ayuusweetfish/Humming-Cumulus/README.md

# Humming Cumulus

[**概念展示动画 / Concept demo animation**](https://ayu.land/flow/rush/Cu_hum.mp4)

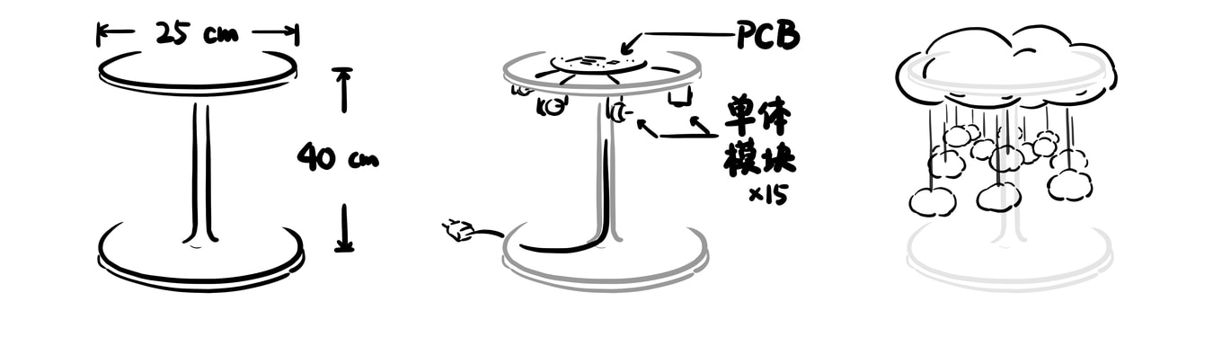
[picture p1: images/CuHum_Appearance.jpg]
外观设计草图。


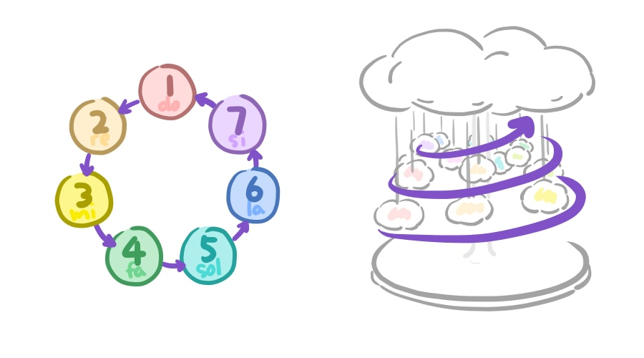
[picture p2: images/CuHum_Solfege.jpg]
按照音名排列的云朵。


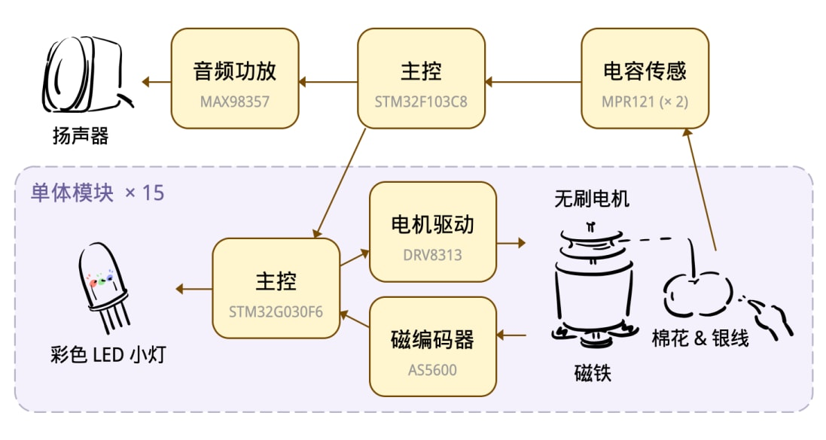
[picture p3: images/CuHum_Block.jpg]
技术原理框图，包括总体的主控和 15 个单体模块。
