ayuusweetfish/Humming-Cumulus/Cloud_Unit/mech/CloudUnit_Chassis.FCStd

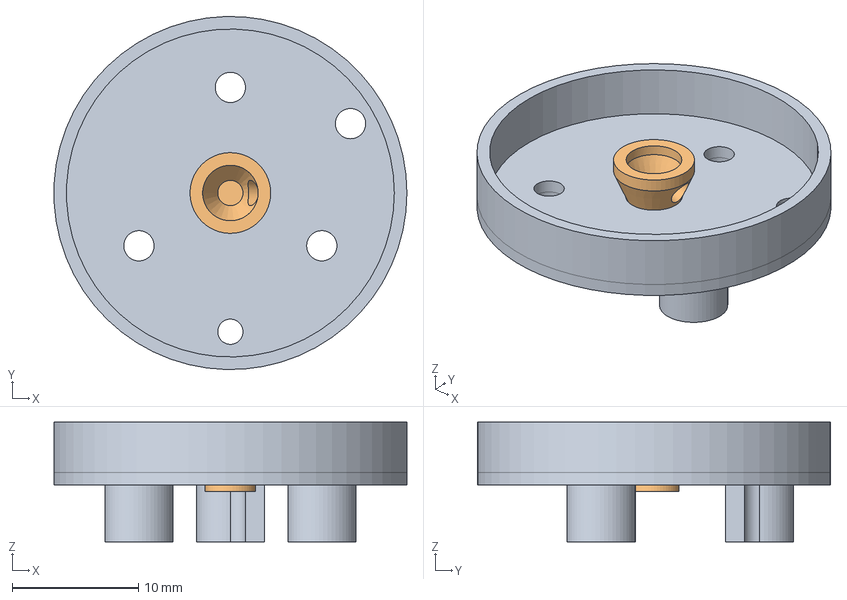
[picture p10: CAD file, 2024-01-27]
Cloud_Unit/mech/CloudUnit_Chassis.FCStd
28.0 x 28.0 x 9.50 mm
