ayuusweetfish/Humming-Cumulus/Cloud_Unit/mech/CloudUnit_Spindle.FCStd

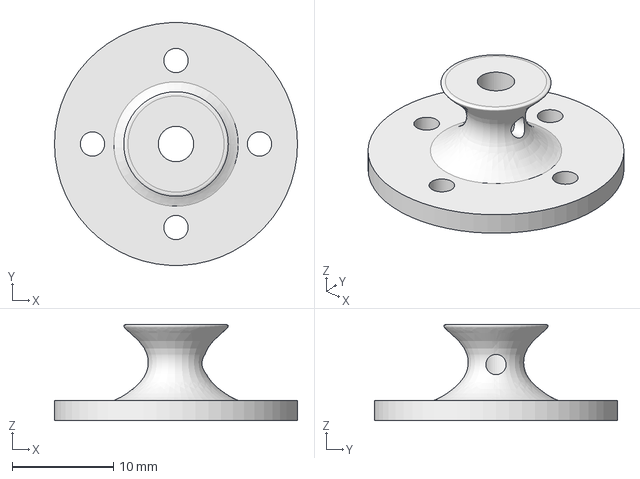
[picture p11: CAD file, 2024-01-27]
Cloud_Unit/mech/CloudUnit_Spindle.FCStd
24.0 x 24.0 x 9.50 mm
