ayuusweetfish/Humming-Cumulus/Cloud_Unit/mech/CloudUnit_ElevRing.FCStd

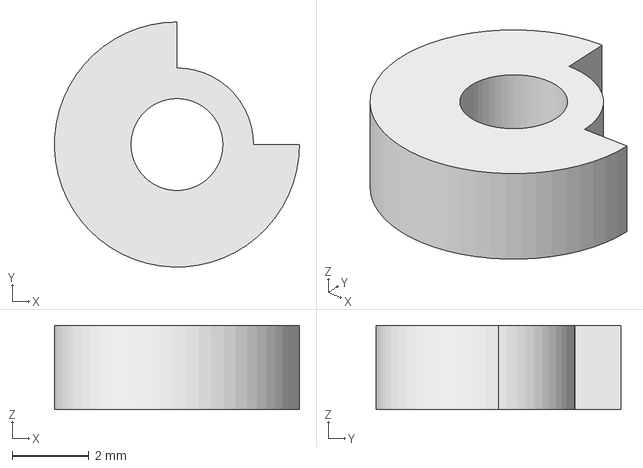
[picture p12: CAD file, 2024-01-07]
Cloud_Unit/mech/CloudUnit_ElevRing.FCStd
6.40 x 6.40 x 2.20 mm
