ayuusweetfish/Humming-Cumulus/misc/paper/Block.pdf

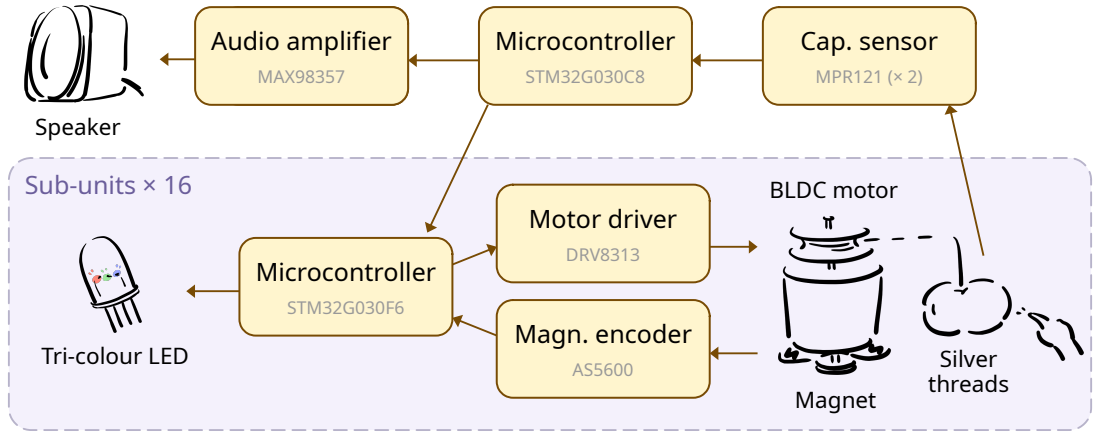
[picture p13: page 1]
Audio Amp; MAX98357; BLDC motor; Magnet; Sub-units × 16; Silver threads; Speaker; Audio amplifier; Microcontroller; STM32G030C8; Cap. sensor; MPR121 (× 2); STM32G030F6; Motor driver; DRV8313; Magn. encoder

Tri-colour LED
