ayuusweetfish/Humming-Cumulus/Main_Board/hw/CuHum_Main.kicad_pcb

## KiCad design Main_Board/hw/CuHum_Main.kicad_pcb (2024-01-27)

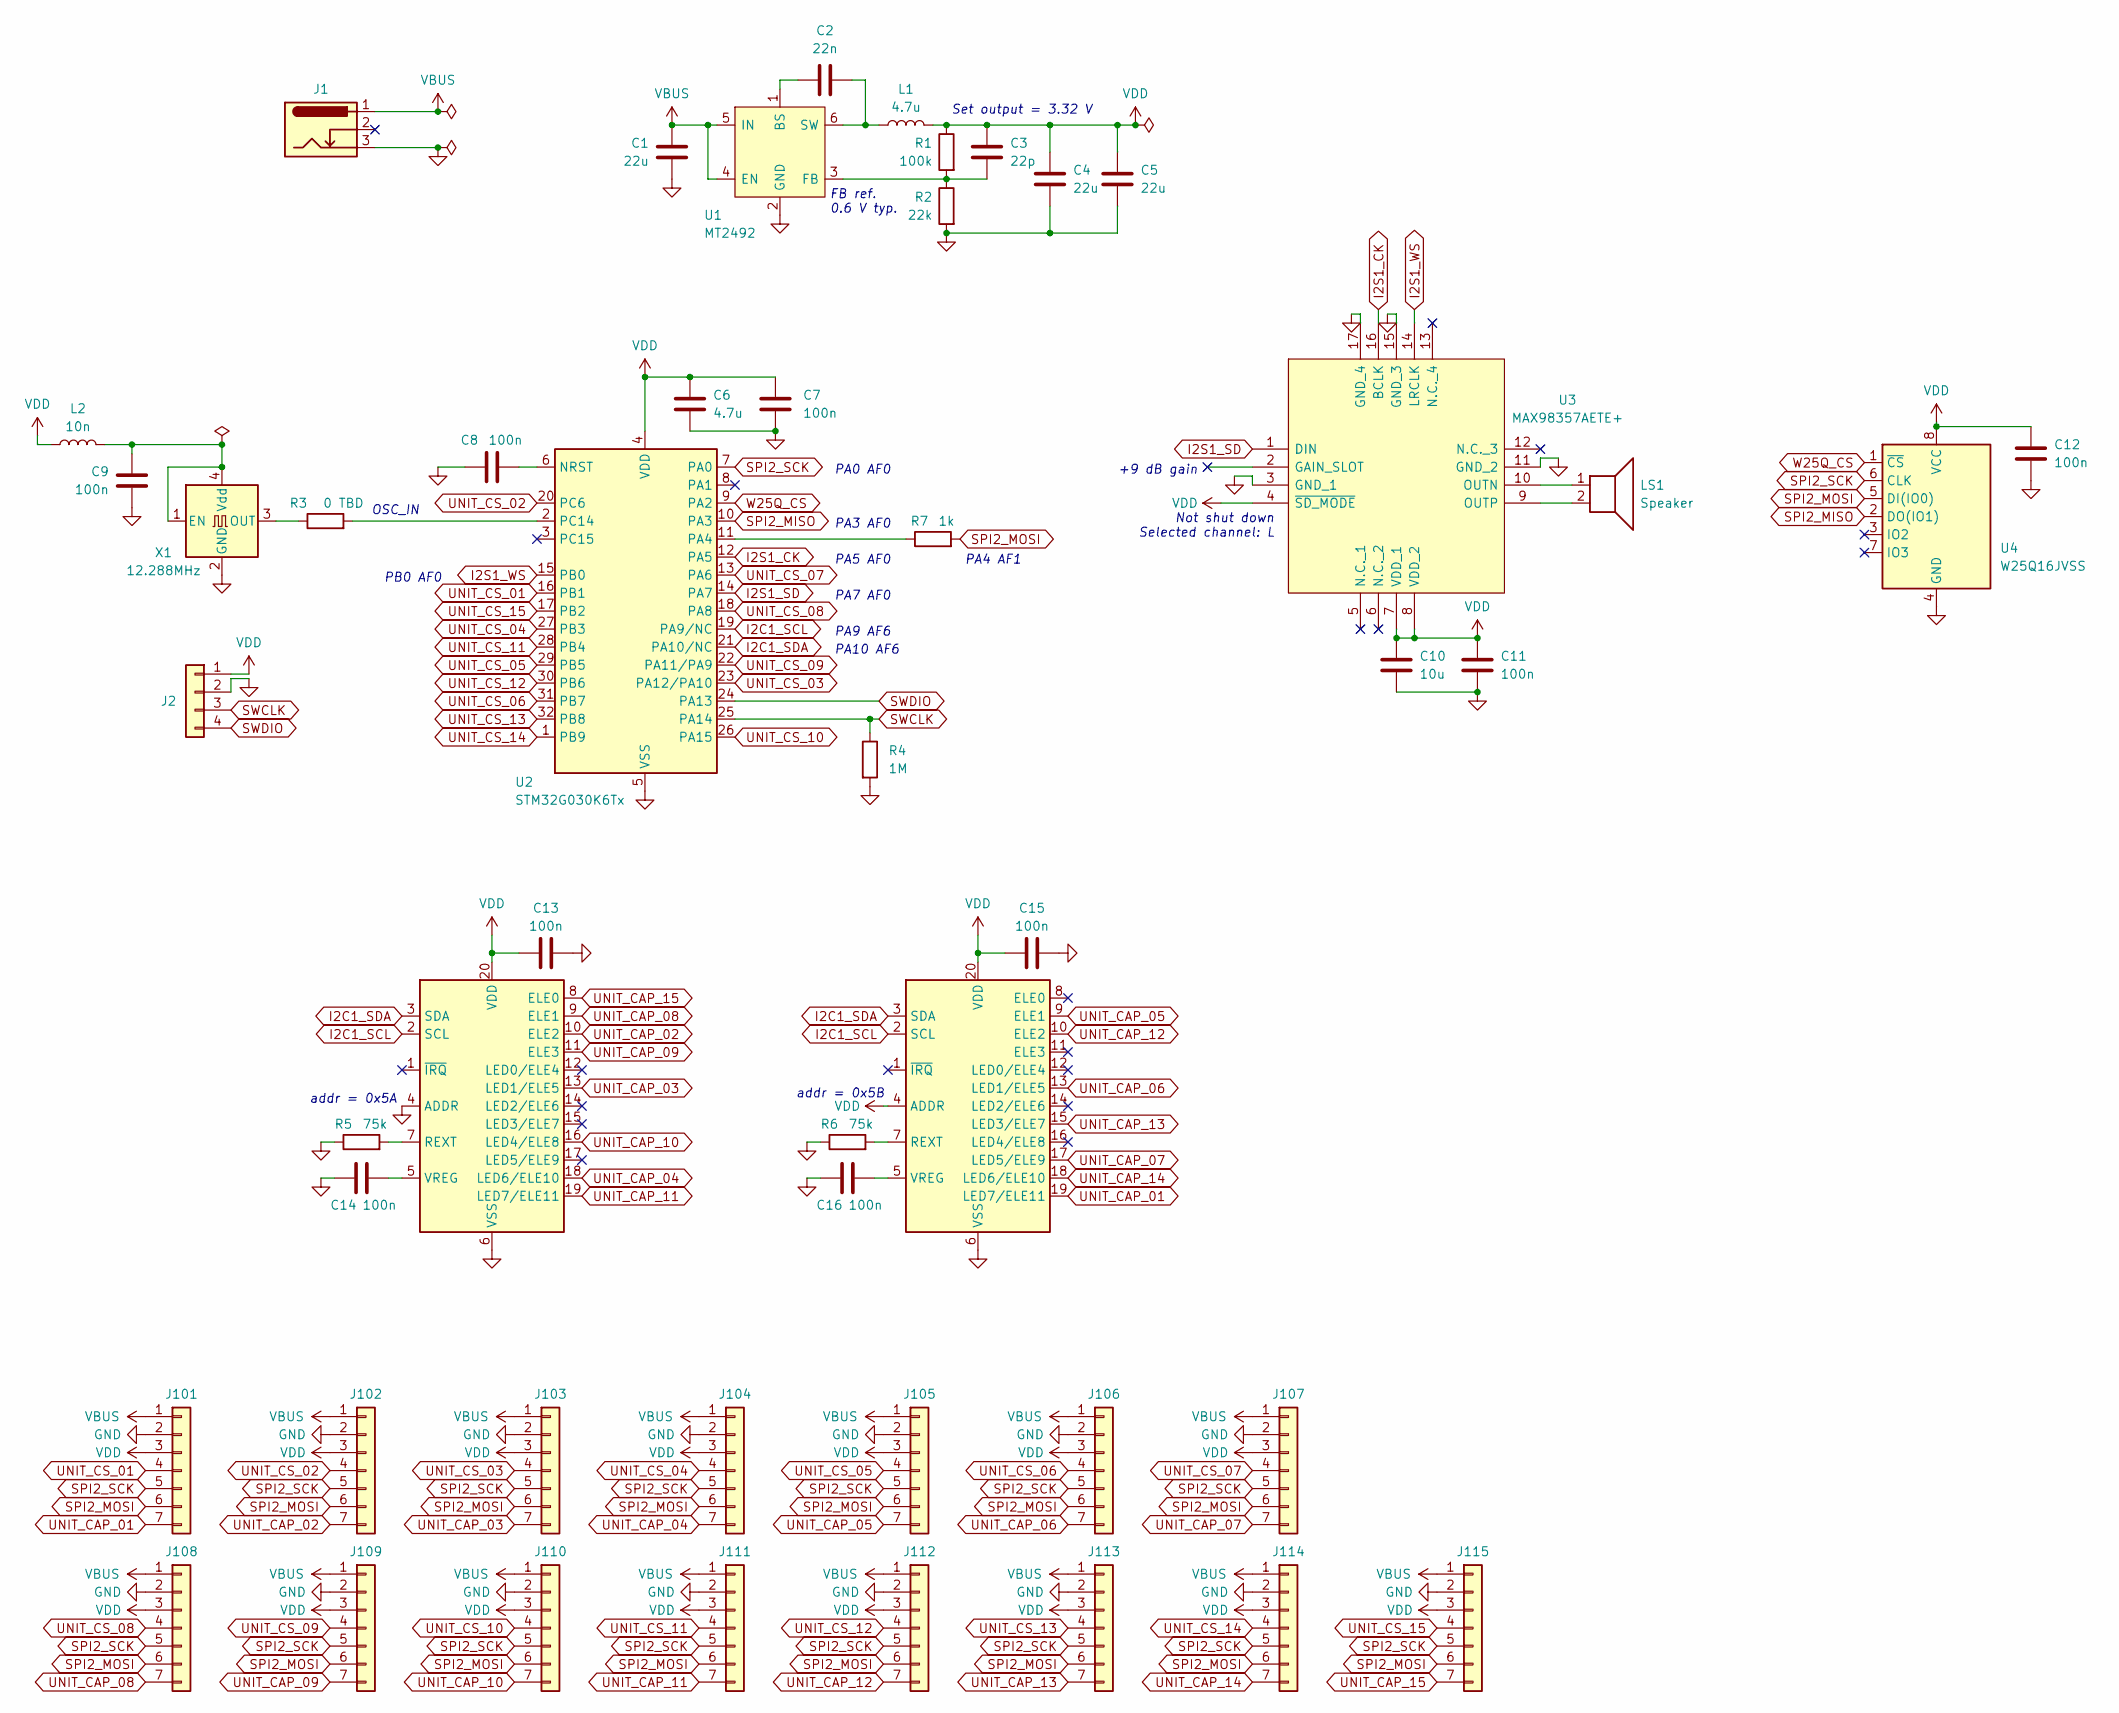
[picture p14: schematic CuHum_Main.kicad_sch]

Parts:
C1, C4, C5: 22u; C_0603_1608Metric
C2: 22n; C_0603_1608Metric
C3: 22p; C_0603_1608Metric
C6: 4.7u; C_0603_1608Metric
C7, C8, C11, C12, C13, C14, C15, C16: 100n; C_0603_1608Metric
C9: 100n; C_0402_1005Metric
C10: 10u; C_0603_1608Metric
J1: Barrel_Jack_Switch_Pin3Ring; BarrelJack_DC022
J2: Conn_01x04; TestPoints_1x04_P2.54
J101, J102, J103, J104, J105, J106, J107, J108, J109, J110, J111, J112, J113, J114, J115: Conn_01x07; Unit_1x07_P2.54
L1: 4.7u; L_Sunlord_MWSA1004S
L2: 10n; L_0402_1005Metric
LS1: Speaker; PinHeader_1x02_P2.54mm_Vertical
R1: 100k; R_0603_1608Metric
R2: 22k; R_0603_1608Metric
R3: 0 TBD; R_0603_1608Metric
R4: 1M; R_0603_1608Metric
R5, R6: 75k; R_0603_1608Metric
R7: 1k; R_0603_1608Metric
U1: MT2492; SOT-23-6; Manufacturer_Part_Number MT2492
U2: STM32G030K6Tx; LQFP-32_7x7mm_P0.8mm
U3: MAX98357AETE+; QFN-16-1EP_3x3mm_P0.5mm_EP1.45x1.45mm; Manufacturer_Part_Number MAX98357AETE+; Mouser Part Number 700-MAX98357AETE+
U4: W25Q16JVSS; SOIC-8_5.23x5.23mm_P1.27mm
U5, U6: MPR121QR2; UQFN-20_3x3mm_P0.4mm
X1: 12.288MHz; Oscillator_SMD_Abracon_ASE-4Pin_3.2x2.5mm

Connections:
GND: C1.2, C4.2, C5.2, C6.2, C7.2, C8.1, C9.2, C10.2, C11.2, C12.2, C13.2, C14.1, C15.2, C16.1, J1.3, J2.2, J101.2, J102.2, J103.2, J104.2, J105.2, J106.2, J107.2, J108.2, J109.2, J110.2, J111.2, J112.2, J113.2, J114.2, J115.2, R2.2, R4.2, R5.1, R6.1, U1.2 (GND), U2.5 (VSS), U3.3 (GND_1), U3.11 (GND_2), U3.15 (GND_3), U3.17 (GND_4), U4.4 (GND), U5.4 (ADDR), U5.6 (VSS), U6.6 (VSS), X1.2 (GND)
I2C1_SCL: U2.19 (PA9/NC), U5.2 (SCL), U6.2 (SCL)
I2C1_SDA: U2.21 (PA10/NC), U5.3 (SDA), U6.3 (SDA)
I2S1_CK: U2.12 (PA5), U3.16 (BCLK)
I2S1_SD: U2.14 (PA7), U3.1 (DIN)
I2S1_WS: U2.15 (PB0), U3.14 (LRCLK)
unnamed: C2.1, U1.1 (BS)
unnamed: C3.2, R1.2, R2.1, U1.3 (FB)
unnamed: C2.2, L1.1, U1.6 (SW)
unnamed: C8.2, U2.6 (NRST)
unnamed: R7.1, U2.11 (PA4)
unnamed: R3.2, U2.2 (PC14)
unnamed: LS1.1, U3.10 (OUTN)
unnamed: LS1.2, U3.9 (OUTP)
unnamed: R5.2, U5.7 (REXT)
unnamed: C14.2, U5.5 (VREG)
unnamed: R6.2, U6.7 (REXT)
unnamed: C16.2, U6.5 (VREG)
unnamed: C9.1, L2.2, X1.1 (EN), X1.4 (Vdd)
unnamed: R3.1, X1.3 (OUT)
SPI2_MISO: U2.10 (PA3), U4.2 (DO(IO1))
SPI2_MOSI: J101.6, J102.6, J103.6, J104.6, J105.6, J106.6, J107.6, J108.6, J109.6, J110.6, J111.6, J112.6, J113.6, J114.6, J115.6, R7.2, U4.5 (DI(IO0))
SPI2_SCK: J101.5, J102.5, J103.5, J104.5, J105.5, J106.5, J107.5, J108.5, J109.5, J110.5, J111.5, J112.5, J113.5, J114.5, J115.5, U2.7 (PA0), U4.6 (CLK)
SWCLK: J2.3, R4.1, U2.25 (PA14)
SWDIO: J2.4, U2.24 (PA13)
UNIT_CAP_01: J101.7, U6.19 (LED7/ELE11)
UNIT_CAP_02: J102.7, U5.10 (ELE2)
UNIT_CAP_03: J103.7, U5.13 (LED1/ELE5)
UNIT_CAP_04: J104.7, U5.18 (LED6/ELE10)
UNIT_CAP_05: J105.7, U6.9 (ELE1)
UNIT_CAP_06: J106.7, U6.13 (LED1/ELE5)
UNIT_CAP_07: J107.7, U6.17 (LED5/ELE9)
UNIT_CAP_08: J108.7, U5.9 (ELE1)
UNIT_CAP_09: J109.7, U5.11 (ELE3)
UNIT_CAP_10: J110.7, U5.16 (LED4/ELE8)
UNIT_CAP_11: J111.7, U5.19 (LED7/ELE11)
UNIT_CAP_12: J112.7, U6.10 (ELE2)
UNIT_CAP_13: J113.7, U6.15 (LED3/ELE7)
UNIT_CAP_14: J114.7, U6.18 (LED6/ELE10)
UNIT_CAP_15: J115.7, U5.8 (ELE0)
UNIT_CS_01: J101.4, U2.16 (PB1)
UNIT_CS_02: J102.4, U2.20 (PC6)
UNIT_CS_03: J103.4, U2.23 (PA12/PA10)
UNIT_CS_04: J104.4, U2.27 (PB3)
UNIT_CS_05: J105.4, U2.29 (PB5)
UNIT_CS_06: J106.4, U2.31 (PB7)
UNIT_CS_07: J107.4, U2.13 (PA6)
UNIT_CS_08: J108.4, U2.18 (PA8)
UNIT_CS_09: J109.4, U2.22 (PA11/PA9)
UNIT_CS_10: J110.4, U2.26 (PA15)
UNIT_CS_11: J111.4, U2.28 (PB4)
UNIT_CS_12: J112.4, U2.30 (PB6)
UNIT_CS_13: J113.4, U2.32 (PB8)
UNIT_CS_14: J114.4, U2.1 (PB9)
UNIT_CS_15: J115.4, U2.17 (PB2)
VBUS: C1.1, J1.1, J101.1, J102.1, J103.1, J104.1, J105.1, J106.1, J107.1, J108.1, J109.1, J110.1, J111.1, J112.1, J113.1, J114.1, J115.1, U1.4 (EN), U1.5 (IN)
VDD: C3.1, C4.1, C5.1, C6.1, C7.1, C10.1, C11.1, C12.1, C13.1, C15.1, J2.1, J101.3, J102.3, J103.3, J104.3, J105.3, J106.3, J107.3, J108.3, J109.3, J110.3, J111.3, J112.3, J113.3, J114.3, J115.3, L1.2, L2.1, R1.1, U2.4 (VDD), U3.4 (~SD_MODE), U3.7 (VDD_1), U3.8 (VDD_2), U4.8 (VCC), U5.20 (VDD), U6.4 (ADDR), U6.20 (VDD)
W25Q_CS: U2.9 (PA2), U4.1 (~CS)

Notes on the sheet:
PA9 AF6
PA0 AF0
OSC_IN
Set output = 3.32 V
FB ref. 0.6 V typ.
PA5 AF0
addr = 0x5B
PB0 AF0
PA10 AF6
addr = 0x5A
+9 dB gain
PA7 AF0
Not shut down Selected channel: L
PA3 AF0
PA4 AF1

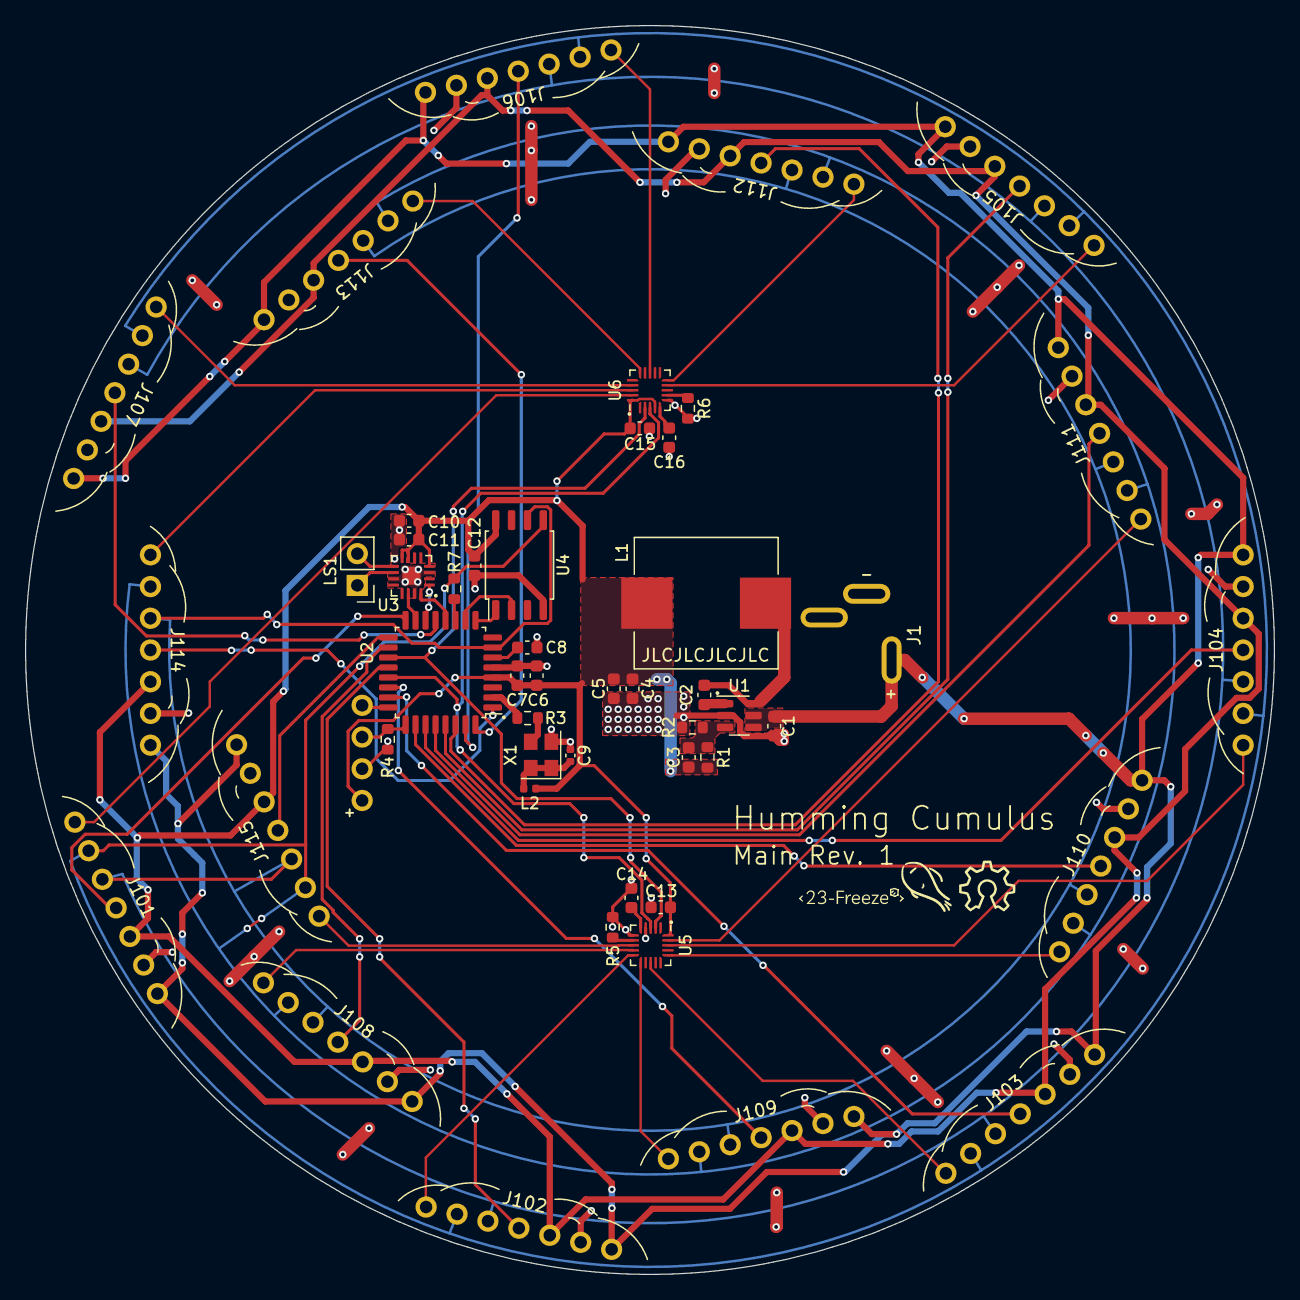
[picture p15: board CuHum_Main.kicad_pcb from above]

Board: 2 copper layers, 100.0 x 100.0 mm, 50 parts (0 on the bottom side), 58 nets.
