ayuusweetfish/Humming-Cumulus/misc/TestDrive_hw/Clouds.kicad_pcb

## KiCad design misc/TestDrive_hw/Clouds.kicad_pcb (2023-11-30)

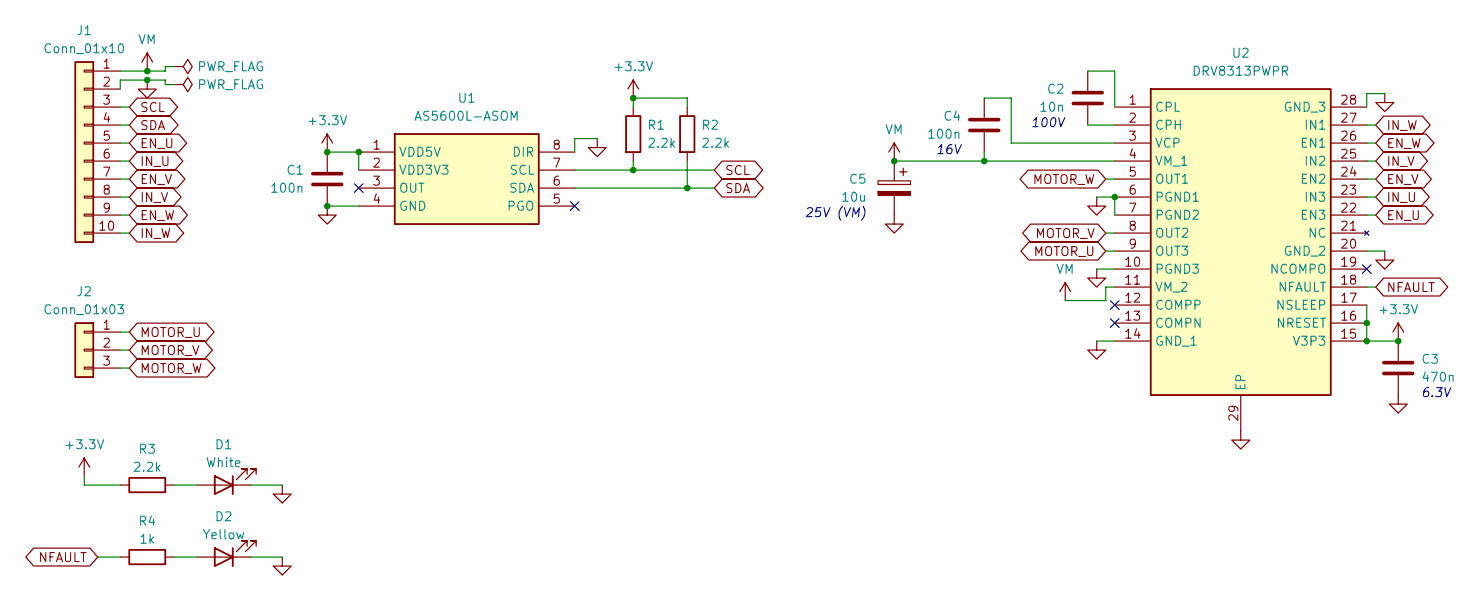
[picture p16: schematic Clouds.kicad_sch]

Parts:
C1, C4: 100n; C_0603_1608Metric
C2: 10n; C_0603_1608Metric
C3: 470n; C_0603_1608Metric
C5: 10u; CP_Elec_5x3.9
D1: White; LED_0805_2012Metric
D2: Yellow; LED_0805_2012Metric
J1: Conn_01x10; PinHeader_1x10_P2.54mm_Vertical
J2: Conn_01x03; PinHeader_1x03_P2.54mm_Vertical
R1, R2, R3: 2.2k; R_0603_1608Metric
R4: 1k; R_0603_1608Metric
U1: AS5600L-ASOM; SOIC127P600X175-8N; Manufacturer_Part_Number AS5600L-ASOM; Mouser Part Number 985-AS5600L-ASOM
U2: DRV8313PWPR; SOP65P640X120-29N; Manufacturer_Part_Number DRV8313PWPR; Mouser Part Number 595-DRV8313PWPR

Connections:
+3.3V: C1.1, C3.1, R1.1, R2.1, R3.1, U1.1 (VDD5V), U1.2 (VDD3V3), U2.15 (V3P3), U2.16 (NRESET), U2.17 (NSLEEP)
EN_U: J1.5, U2.22 (EN3)
EN_V: J1.7, U2.24 (EN2)
EN_W: J1.9, U2.26 (EN1)
GND: C1.2, C3.2, C5.2, D1.1 (K), D2.1 (K), J1.2, U1.4 (GND), U1.8 (DIR), U2.6 (PGND1), U2.7 (PGND2), U2.10 (PGND3), U2.14 (GND_1), U2.20 (GND_2), U2.28 (GND_3), U2.29 (EP)
IN_U: J1.6, U2.23 (IN3)
IN_V: J1.8, U2.25 (IN2)
IN_W: J1.10, U2.27 (IN1)
MOTOR_U: J2.1, U2.9 (OUT3)
MOTOR_V: J2.2, U2.8 (OUT2)
MOTOR_W: J2.3, U2.5 (OUT1)
NFAULT: R4.1, U2.18 (NFAULT)
unnamed: D1.2 (A), R3.2
unnamed: D2.2 (A), R4.2
unnamed: C2.2, U2.2 (CPH)
unnamed: C2.1, U2.1 (CPL)
unnamed: C4.1, U2.3 (VCP)
SCL: J1.3, R1.2, U1.7 (SCL)
SDA: J1.4, R2.2, U1.6 (SDA)
VM: C4.2, C5.1, J1.1, U2.4 (VM_1), U2.11 (VM_2)

Notes on the sheet:
25V (VM)
16V
100V
6.3V

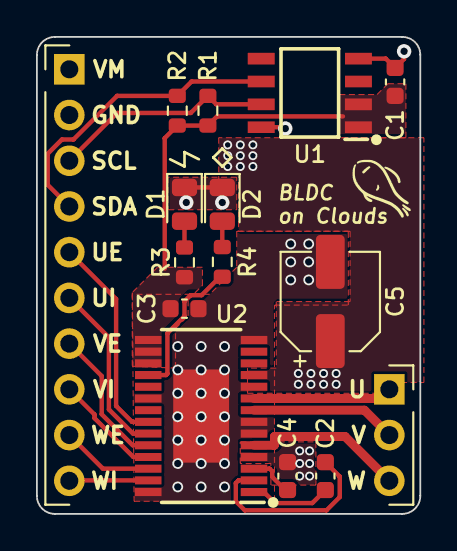
[picture p17: board misc/TestDrive_hw/Clouds.kicad_pcb from above]

Board: 2 copper layers, 21.3 x 26.5 mm, 15 parts (0 on the bottom side), 20 nets.
