ayuusweetfish/Humming-Cumulus/Cloud_Unit/hw/Clouds.kicad_pcb

## KiCad design Cloud_Unit/hw/Clouds.kicad_pcb (2023-12-22)

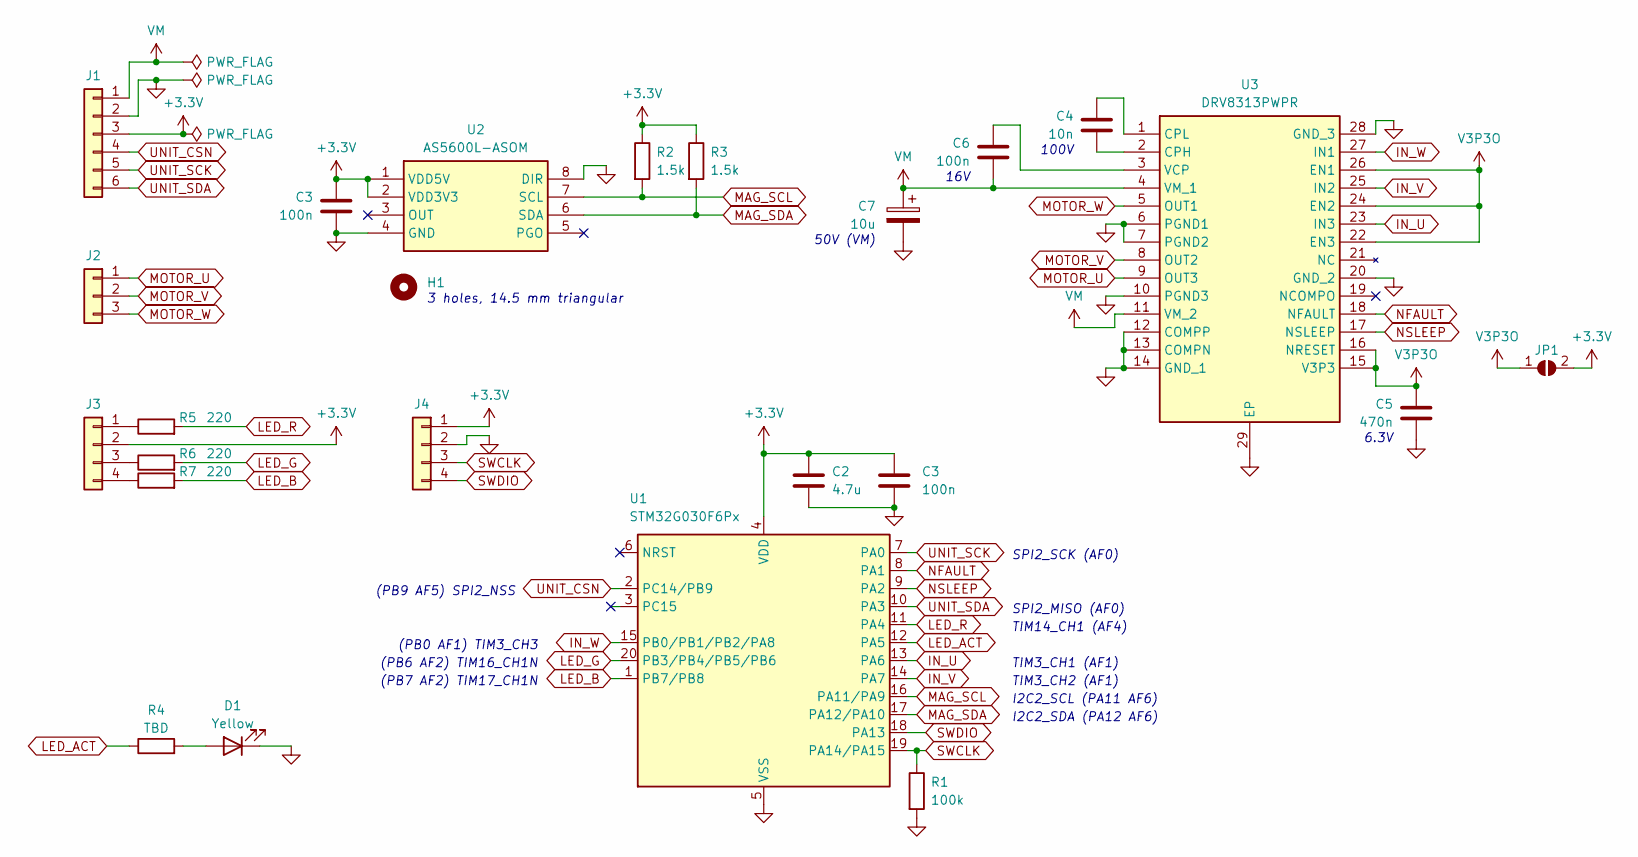
[picture p18: schematic Clouds.kicad_sch]

Parts:
C2: 4.7u; C_0603_1608Metric
C3, C6: 100n; C_0603_1608Metric
C4: 10n; C_0603_1608Metric
C5: 470n; C_0805_2012Metric
C7: 10u; CP_Elec_5x3.9
D1: Yellow; LED_0603_1608Metric
H1: MountingHole; MountingHoles_M3_Tri14.5
J1: Conn_01x06; PinHeader_1x06_P2.54mm_Vertical
J2: Conn_01x03; PinHeader_1x03_P2.54mm_Vertical
J3: Conn_01x04; PinHeader_1x04_P2.00mm_Vertical
J4: Conn_01x04; TestPoints_1x04_P2.0
JP1: SolderJumper_2_Open; SolderJumper-2_P1.3mm_Open_RoundedPad1.0x1.5mm
R1: 100k; R_0603_1608Metric
R2, R3: 1.5k; R_0603_1608Metric
R4: TBD; R_0603_1608Metric
R5, R6, R7: 220; R_0603_1608Metric
U1: STM32G030F6Px; TSSOP-20_4.4x6.5mm_P0.65mm
U2: AS5600L-ASOM; SOIC127P600X175-8N; Manufacturer_Part_Number AS5600L-ASOM; Mouser Part Number 985-AS5600L-ASOM
U3: DRV8313PWPR; SOP65P640X120-29N; Manufacturer_Part_Number DRV8313PWPR; Mouser Part Number 595-DRV8313PWPR

Connections:
+3.3V: C2.1, C3.1, J1.3, J3.2, J4.1, JP1.2 (B), R2.1, R3.1, U1.4 (VDD), U2.1 (VDD5V), U2.2 (VDD3V3); also elsewhere on the board
GND: C2.2, C3.2, C5.2, C7.2, D1.1 (K), J1.2, J4.2, R1.2, U1.5 (VSS), U2.4 (GND), U2.8 (DIR), U3.6 (PGND1), U3.7 (PGND2), U3.10 (PGND3), U3.12 (COMPP), U3.13 (COMPN), U3.14 (GND_1), U3.20 (GND_2), U3.28 (GND_3), U3.29 (EP); also elsewhere on the board
IN_U: U1.13 (PA6), U3.23 (IN3)
IN_V: U1.14 (PA7), U3.25 (IN2)
IN_W: U1.15 (PB0/PB1/PB2/PA8), U3.27 (IN1)
LED_ACT: R4.1, U1.12 (PA5)
LED_B: R7.2, U1.1 (PB7/PB8)
LED_G: R6.2, U1.20 (PB3/PB4/PB5/PB6)
LED_R: R5.2, U1.11 (PA4)
MAG_SCL: R2.2, U1.16 (PA11/PA9), U2.7 (SCL)
MAG_SDA: R3.2, U1.17 (PA12/PA10), U2.6 (SDA)
MOTOR_U: J2.1, U3.9 (OUT3)
MOTOR_V: J2.2, U3.8 (OUT2)
MOTOR_W: J2.3, U3.5 (OUT1)
NFAULT: U1.8 (PA1), U3.18 (NFAULT)
NSLEEP: U1.9 (PA2), U3.17 (NSLEEP)
unnamed: D1.2 (A), R4.2
unnamed: J3.1, R5.1
unnamed: J3.3, R6.1
unnamed: J3.4, R7.1
unnamed: C4.2, U3.2 (CPH)
unnamed: C4.1, U3.1 (CPL)
unnamed: C6.1, U3.3 (VCP)
SWCLK: J4.3, R1.1, U1.19 (PA14/PA15)
SWDIO: J4.4, U1.18 (PA13)
UNIT_CSN: J1.4, U1.2 (PC14/PB9)
UNIT_SCK: J1.5, U1.7 (PA0)
UNIT_SDA: J1.6, U1.10 (PA3)
V3P3O: C5.1, JP1.1 (A), U3.15 (V3P3), U3.16 (NRESET), U3.22 (EN3), U3.24 (EN2), U3.26 (EN1)
VM: C6.2, C7.1, J1.1, U3.4 (VM_1), U3.11 (VM_2)

Notes on the sheet:
I2C2_SCL (PA11 AF6)
I2C2_SDA (PA12 AF6)
(PB0 AF1) TIM3_CH3
SPI2_SCK (AF0)
(PB7 AF2) TIM17_CH1N
50V (VM)
16V
(PB9 AF5) SPI2_NSS
(PB6 AF2) TIM16_CH1N
100V
TIM3_CH1 (AF1)
TIM3_CH2 (AF1)
TIM14_CH1 (AF4)
6.3V
SPI2_MISO (AF0)
3 holes, 14.5 mm triangular

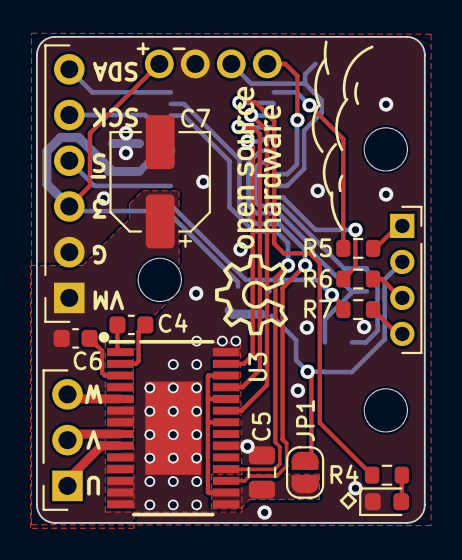
[picture p19: board Cloud_Unit/hw/Clouds.kicad_pcb from above]

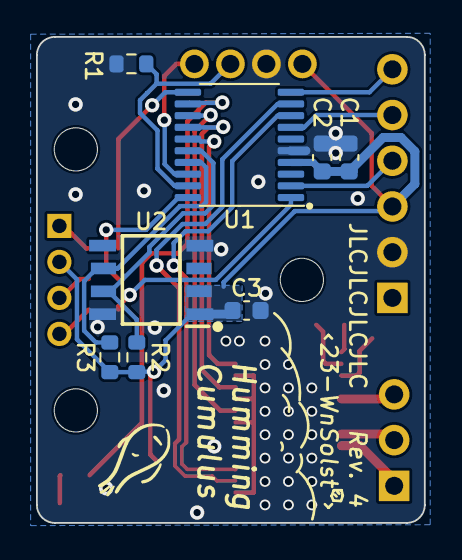
[picture p20: board Cloud_Unit/hw/Clouds.kicad_pcb from below]

Board: 2 copper layers, 21.6 x 27.0 mm, 24 parts (8 on the bottom side), 30 nets.

Other parts of the board:
C1: 4.7u; C_0603_1608Metric

Their connections:
+3.3V: C1.1; also elsewhere on the board
GND: C1.2; also elsewhere on the board
