ayuusweetfish/Humming-Cumulus/(commit log)

2023-11-30 Add ECAD libraries for IC components
    [Clouds.kicad_pcb, Clouds.kicad_sch]
2023-11-30 Finish schematics
    [Clouds.kicad_sch]
2023-11-30 Revise schematic
    [Clouds.kicad_sch]
2023-11-30 (WIP) PCB layout
    [Clouds.kicad_pcb, Clouds.kicad_sch]
2023-11-30 (WIP) Almost-complete layout
    [Clouds.kicad_pcb]
2023-11-30 Finish PCB design
    [Clouds.kicad_pcb]
2023-11-30 Prepare test drive board for fabrication
    [Clouds.kicad_pcb]
2023-12-01 Create new unit controller board
    [Clouds.kicad_pcb, Clouds.kicad_sch]
2023-12-01 (WIP) Layout of driver board
    [Clouds.kicad_pcb, Clouds.kicad_sch]
2023-12-01 (WIP) Try routing
    [Clouds.kicad_pcb]
2023-12-01 Finish driver board design
    [Clouds.kicad_pcb]
2023-12-01 Fix motor's wire order
    [Clouds.kicad_pcb, Clouds.kicad_sch]
2023-12-08 ✨ Start work on firmware, blinking
2023-12-08 Blinking RGB LED
2023-12-08 PWM test by fading LED
2023-12-08 Read values from magnetic encoder
2023-12-08 🌀 Fade & dim lights according to the magnet!
2023-12-11 Update boards with NPTH screw holes
    [Clouds.kicad_pcb, Clouds.kicad_sch]
2023-12-11 Add I2S audio test on development board
2023-12-11 Test externally-triggered timer
2023-12-11 Test timer synchronisation with serial clock signal
2023-12-12 (WIP) Output signals to the driver IC
    [Clouds.kicad_sch]
2023-12-13 PWM to driver pins
2023-12-14 (WIP) Adjust PWM to driver pins
2023-12-18 Correctly driving BLDC motor
    [main.c]
2023-12-18 Rotate the motor back and forth
2023-12-20 Enable PLL, output PWM at higher frequency
2023-12-21 Update clouds unit PCB with new motor dimensions
    [Clouds.kicad_pcb, Clouds.kicad_sch]
2023-12-21 Further revise PCB design
    [Clouds.kicad_pcb]
2023-12-22 Revise PCB and submit for fabrication (Rev. 4)
    [Clouds.kicad_pcb]
2023-12-31 Upload FW onto updated HW; only read mag encoder
2024-01-01 Add a mechanical part for elevation of the motor
    [CloudUnit_ElevRing.FCStd]
2024-01-03 Update mechanical parts
    [CloudUnit_ElevRing.FCStd, CloudUnit_Spindle.FCStd]
2024-01-07 Revise mechanical parts for the pulley
    [CloudUnit_ElevRing.FCStd, CloudUnit_Spindle.FCStd]
2024-01-16 Optimise spindle dimensions
    [CloudUnit_Spindle.FCStd]
2024-01-16 Bring back encoder read-outs in firmware
2024-01-17 Signal on I2C errors
    [main.c]
2024-01-18 Add motor chassis model
    [CloudUnit_Chassis.FCStd]
2024-01-18 Revise incorrect chassis model
    [CloudUnit_Chassis.FCStd]
2024-01-23 Revise cloud unit chassis part
    [CloudUnit_Chassis.FCStd]
2024-01-24 Revise chassis model again
    [CloudUnit_Chassis.FCStd]
2024-01-24 Reorganise directory structure
    [CloudUnit_Chassis.FCStd, CloudUnit_ElevRing.FCStd, CloudUnit_Spindle.FCStd, Clouds.kicad_pcb, Clouds.kicad_sch]
2024-01-24 Add schematic for the main board
    [CuHum_Main.kicad_pcb, CuHum_Main.kicad_sch]
2024-01-25 Finish main board layout
    [CuHum_Main.kicad_pcb, CuHum_Main.kicad_sch]
2024-01-26 (WIP) Main board layout & routing
    [CuHum_Main.kicad_pcb, CuHum_Main.kicad_sch]
2024-01-26 Finish main board routing
    [CuHum_Main.kicad_pcb, CuHum_Main.kicad_sch]
2024-01-27 Finish main board design
    [CuHum_Main.kicad_pcb]
2024-01-27 Revise mechanical parts, again
    [CloudUnit_Chassis.FCStd, CloudUnit_Spindle.FCStd]
